chillybeans-23/oae_hardware/oae/oae.png

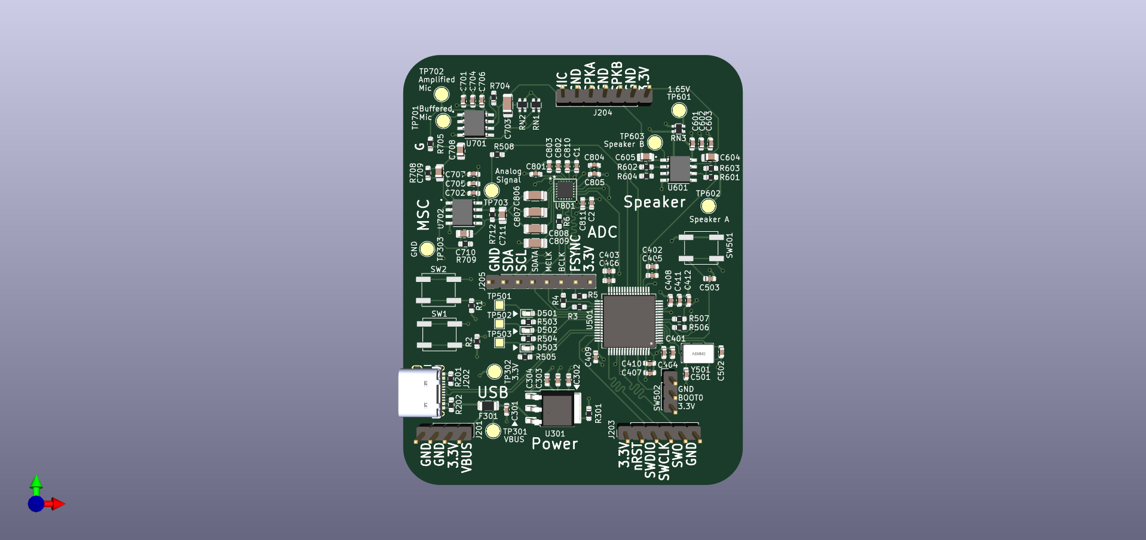
oae/oae.png
