chillybeans-23/oae_hardware/README.md

# OAE Hardware

PCB designs for the OAE prototype.
