chillybeans-23/oae_hardware/physical_ui_prototypes/documentation.md

Purpose: so future students know how reproduce the LED and LCD devices we made. They also have an idea of how to build on our work (keyfob, learnings from codesigns and assembly)

We developed an LCD and an LED UI prototype of the DPOAE device.
