chillybeans-23/oae_hardware/oae/bom.xlsx

Id | Designator | Footprint | Quantity | Comment | Supplier and ref
1 | TP302 | TestPoint_Pad_D2.5mm | 1 | 3V3
2 | C304,C704,C404,C408,C801,C409,C503,C810,C705,C602 | C_0603_1608Metric | 10 | 1uF
3 | C702,C601,C405,C406,C410,C701,C412 | C_0603_1608Metric | 7 | 100nF
4 | J206 | PinHeader_1x05_P2.54mm_Vertical | 1 | BMS Connector
5 | C804,C301,C706,C811,C603,C303,C802,C707,C401 | C_0603_1608Metric | 9 | 10uF
6 | TP701 | TestPoint_Pad_D2.5mm | 1 | MIC_BUFF
7 | R504,R503,R505 | R_0603_1608Metric_Pad0.98x0.95mm_HandSolder | 3 | 200
8 | R201,R202 | R_0603_1608Metric_Pad0.98x0.95mm_HandSolder | 2 | 5.1K
9 | J207 | PinHeader_1x06_P2.54mm_Vertical | 1 | GPIO Header
10 | R604,R603 | R_0603_1608Metric_Pad0.98x0.95mm_HandSolder | 2 | 499
11 | C605,C604 | C_0805_2012Metric_Pad1.18x1.45mm_HandSolder | 2 | >2uF
12 | R708,R709,R705,R712 | R_0603_1608Metric_Pad0.98x0.95mm_HandSolder | 4 | 2K
13 | TP502 | TestPoint_Pad_1.5x1.5mm | 1 | DBG2
14 | C708,C710 | C_0805_2012Metric_Pad1.18x1.45mm_HandSolder | 2 | 100nF
15 | RN3,RN1,RN2 | R_Array_Convex_2x0603 | 3 | 10K
16 | C2,C803,C805,C1 | C_0603_1608Metric | 4 | 0.1uF
17 | TP603 | TestPoint_Pad_D2.5mm | 1 | SPEAKER_B
18 | C502,C501 | C_0603_1608Metric | 2 | 16pF
19 | R301,R12 | R_0603_1608Metric_Pad0.98x0.95mm_HandSolder | 2 | 0
20 | TP303 | TestPoint_Pad_D2.5mm | 1 | GND
21 | R17,R10,R15,R16,R11,R18 | R_0603_1608Metric_Pad0.98x0.95mm_HandSolder | 6 | 4.7K
22 | J202 | GCT_USB4105-GF-A | 1 | USB_C_Micro
23 | J201 | PinHeader_1x04_P2.54mm_Vertical | 1 | Power Terminal
24 | SW2,SW1 | SW_SPST_EVPBF | 2 | BTN1
25 | TP501 | TestPoint_Pad_1.5x1.5mm | 1 | DBG1
26 | R704,R14,R13 | R_0603_1608Metric_Pad0.98x0.95mm_HandSolder | 3 | 100K
27 | F301 | Fuse_1206_3216Metric | 1 | 1A
28 | J204 | PinHeader_1x07_P2.54mm_Vertical | 1 | Earpiece Connector
29 | D503 | LED_0603_1608Metric | 1 | DBG3
30 | TP301 | TestPoint_Pad_D2.5mm | 1 | VBUS
31 | C809,C703,C806,C808,C807 | C_1206_3216Metric_Pad1.33x1.80mm_HandSolder | 5 | 1uF
32 | R9,R7,R8,R6 | R_0603_1608Metric_Pad0.98x0.95mm_HandSolder | 4 | 33
33 | SW501 | SW_SPST_EVPBF | 1 | RST_BTN
34 | U701 | SOIC127P599X175-8N | 1 | Opamp_Buffer
35 | J203 | PinHeader_1x06_P2.54mm_Vertical | 1 | Programming Header
36 | R602,R601 | R_0603_1608Metric_Pad0.98x0.95mm_HandSolder | 2 | 10K
37 | TP601 | TestPoint_Pad_D2.5mm | 1 | 1V65
38 | C302 | C_0603_1608Metric | 1 | 22uF
39 | TP703 | TestPoint_Pad_D2.5mm | 1 | MIC_FILTERED
40 | C711,C709 | C_0805_2012Metric_Pad1.18x1.45mm_HandSolder | 2 | 10nF
41 | TP503 | TestPoint_Pad_1.5x1.5mm | 1 | DBG3
42 | C411 | C_0603_1608Metric | 1 | 10nF
43 | Y501 | XTAL_ABMM2-8.000MHZ-E2-T | 1 | 8MHz
44 | U702 | SOIC127P599X175-8N | 1 | Bandpass
45 | U3 | LQFP-64_10x10mm_P0.5mm | 1 | STM32L496RGTx
46 | C402,C407,C403 | C_0603_1608Metric | 3 | 4.7uF
47 | SW502 | PinHeader_1x03_P2.54mm_Vertical | 1 | SW_SPDT
48 | U601 | SOIC127P599X175-8N | 1 | Opamp_Speaker
49 | TP602 | TestPoint_Pad_D2.5mm | 1 | SPEAKER_A
50 | U301 | TO-252-3_TabPin2 | 1 | AZ1117-3.3
51 | D502 | LED_0603_1608Metric | 1 | DBG2
52 | U801 | WQFN20_RTE_TEX | 1 | TLV320ADC3120IRTER
53 | D501 | LED_0603_1608Metric | 1 | DBG1
54 | J205 | PinHeader_1x08_P2.54mm_Vertical | 1 | Communication Pins
55 | TP702 | TestPoint_Pad_D2.5mm | 1 | MIC_AMP
56 | J1 | HDMI_A_Molex_208658-1001_Horizontal | 1 | HDMI_A_1.4
