chillybeans-23/oae_hardware/oae/oae.kicad_pcb

## KiCad design oae/oae.kicad_pcb (2025-02-10)

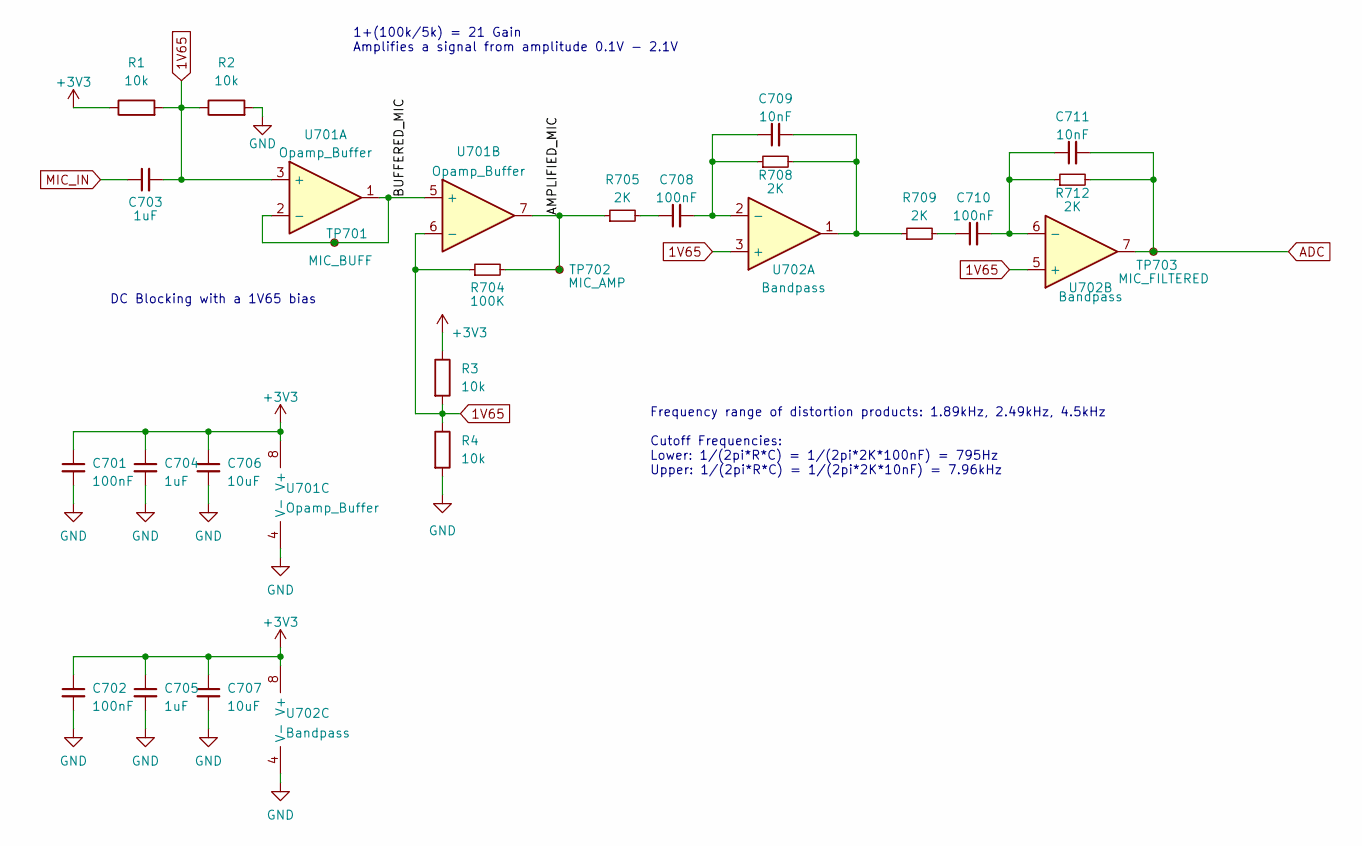
[picture p2: schematic microphone_filter.kicad_sch]

Parts:
C701, C702: 100nF; C_0603_1608Metric
C703: 1uF; C_1206_3216Metric_Pad1.33x1.80mm_HandSolder
C704, C705: 1uF; C_0603_1608Metric
C706, C707: 10uF; C_0603_1608Metric
C708, C710: 100nF; C_1206_3216Metric
C709, C711: 10nF; C_0603_1608Metric
R1, R2, R3, R4: 10k; R_0603_1608Metric
R704: 100K; R_0603_1608Metric_Pad0.98x0.95mm_HandSolder
R705, R708, R709, R712: 2K; R_0603_1608Metric_Pad0.98x0.95mm_HandSolder
TP701: MIC_BUFF; TestPoint_Pad_D2.5mm
TP702: MIC_AMP; TestPoint_Pad_D2.5mm
TP703: MIC_FILTERED; TestPoint_Pad_D2.5mm
U1: PCM1862DBT; C_0603_1608Metric
U701: Opamp_Buffer; SOIC127P599X175-8N; Digikey MCP6022-I/SN-ND
U702: Bandpass; SOIC127P599X175-8N; Digikey MCP6022-I/SN-ND

Connections:
1V65: C703.2, R1.2, R2.1, R3.2, R4.1, R704.1, U701.3 (+), U701.6 (-), U702.3 (+), U702.5 (+); also elsewhere on the board
+3V3: C701.1, C702.1, C704.1, C705.1, C706.1, C707.1, R1.1, R3.1, U701.8 (V+), U702.8 (V+); also elsewhere on the board
/Microphone Filters and Amp/AMPLIFIED_MIC: R704.2, R705.1, TP702.1, U701.7
/Microphone Filters and Amp/BUFFERED_MIC: TP701.1, U701.1, U701.2 (-), U701.5 (+)
ADC: C711.2, R712.2, TP703.1, U702.7; also elsewhere on the board
GND: C701.2, C702.2, C704.2, C705.2, C706.2, C707.2, R2.2, R4.2, U701.4 (V-), U702.4 (V-); also elsewhere on the board
MIC_IN: C703.1; also elsewhere on the board
unnamed: C708.1, R705.2
unnamed: C709.2, R708.2, R709.1, U702.1
unnamed: C710.1, R709.2
unnamed: C708.2, C709.1, R708.1, U702.2 (-)
unnamed: C710.2, C711.1, R712.1, U702.6 (-)

Notes on the sheet:
1+(100k/5k) = 21 Gain Amplifies a signal from amplitude 0.1V - 2.1V
DC Blocking with a 1V65 bias
Frequency range of distortion products: 1.89kHz, 2.49kHz, 4.5kHz Cutoff Frequencies: Lower: 1/(2pi*R*C) = 1/(2pi*2K*100nF) = 795Hz Upper: 1/(2pi*R*C) = 1/(2pi*2K*10nF) = 7.96kHz

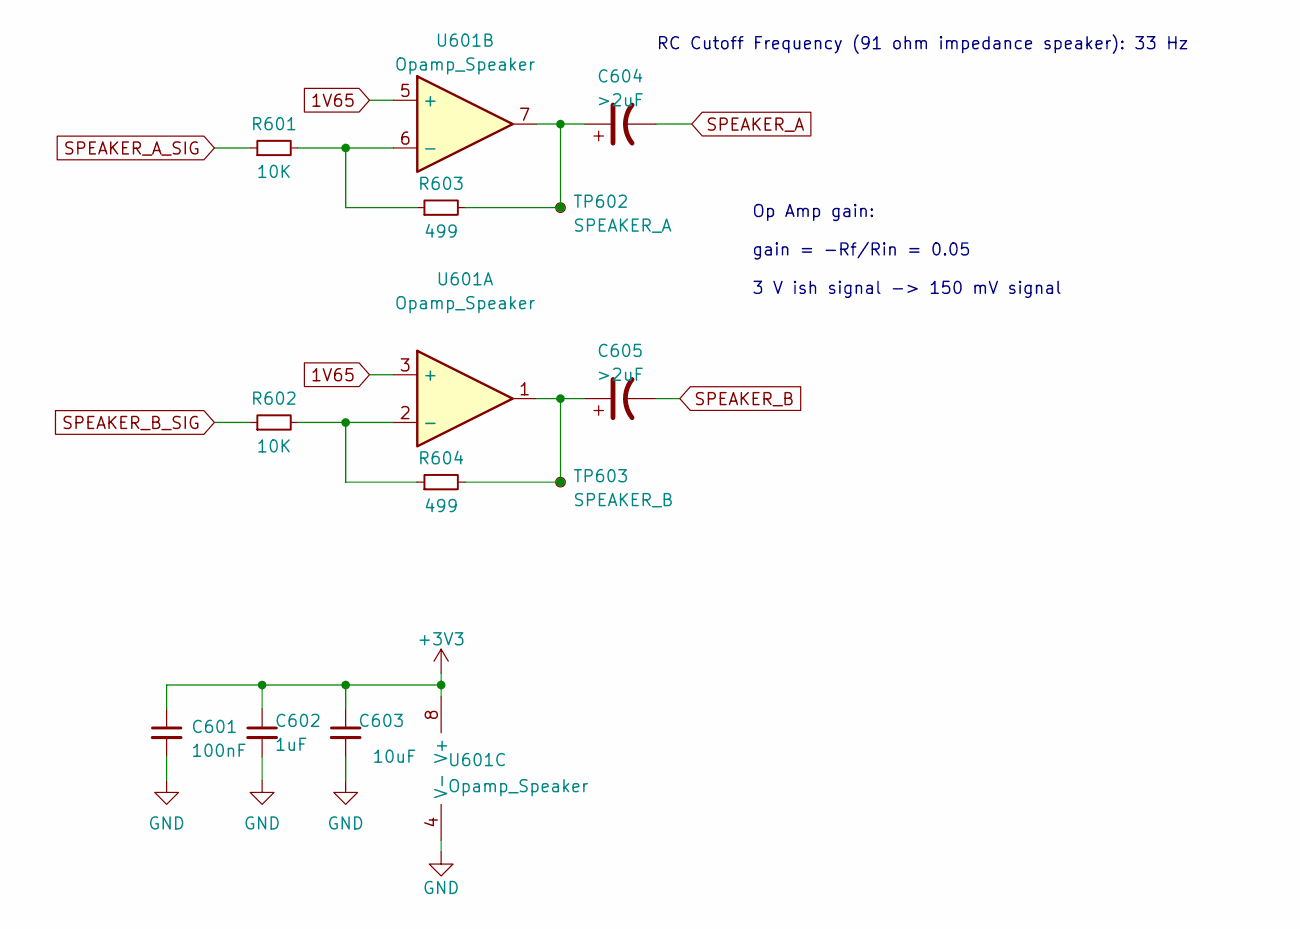
[picture p3: schematic speaker_amp.kicad_sch]

Parts:
C601: 100nF; C_0603_1608Metric
C602: 1uF; C_0603_1608Metric
C603: 10uF; C_0603_1608Metric
C604, C605: >2uF; C_0805_2012Metric_Pad1.18x1.45mm_HandSolder
R601, R602: 10K; R_0603_1608Metric_Pad0.98x0.95mm_HandSolder
R603, R604: 499; R_0603_1608Metric_Pad0.98x0.95mm_HandSolder
TP602: SPEAKER_A; TestPoint_Pad_D2.5mm
TP603: SPEAKER_B; TestPoint_Pad_D2.5mm
U601: Opamp_Speaker; SOIC127P599X175-8N; Digikey MCP6022-I/SN-ND

Connections:
1V65: U601.3 (+), U601.5 (+); also elsewhere on the board
+3V3: C601.1, C602.1, C603.1, U601.8 (V+); also elsewhere on the board
GND: C601.2, C602.2, C603.2, U601.4 (V-); also elsewhere on the board
unnamed: C604.1, R603.2, TP602.1, U601.7
unnamed: C605.1, R604.2, TP603.1, U601.1
unnamed: R602.2, R604.1, U601.2 (-)
unnamed: R601.2, R603.1, U601.6 (-)
SPEAKER_A: C604.2; also elsewhere on the board
SPEAKER_A_SIG: R601.1; also elsewhere on the board
SPEAKER_B: C605.2; also elsewhere on the board
SPEAKER_B_SIG: R602.1; also elsewhere on the board

Notes on the sheet:
Op Amp gain: gain = -Rf/Rin = 0.05 3 V ish signal -> 150 mV signal
RC Cutoff Frequency (91 ohm impedance speaker): 33 Hz

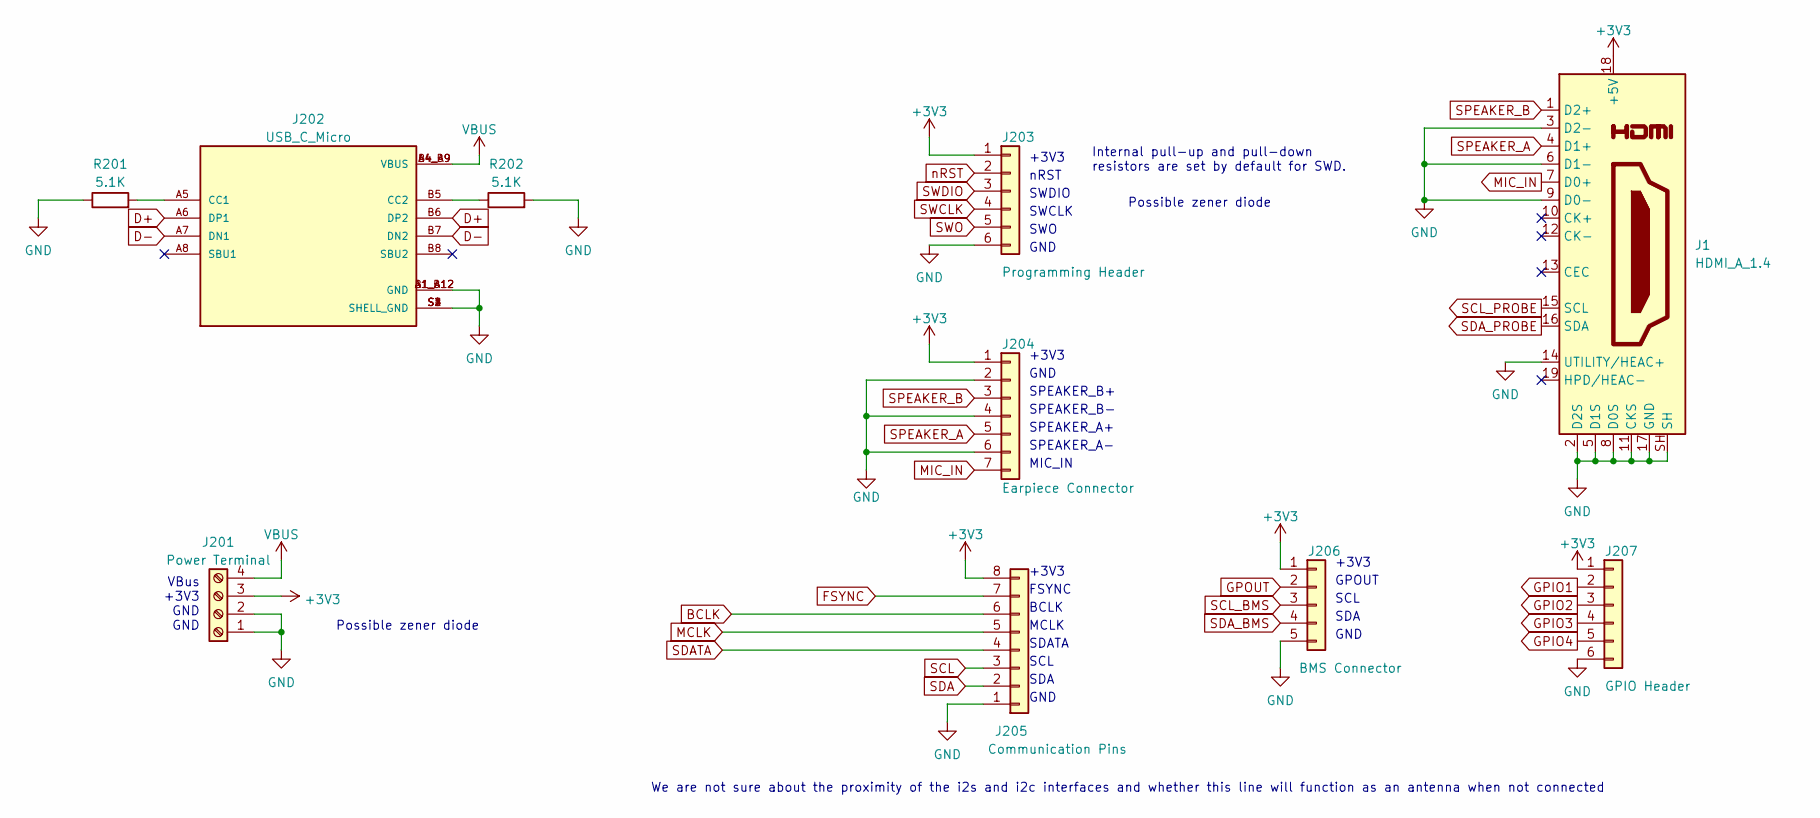
[picture p4: schematic interface.kicad_sch]

Parts:
J1: HDMI_A_1.4; HDMI_A_Molex_208658-1001_Horizontal
J201: Power Terminal; PinHeader_1x04_P2.54mm_Vertical
J202: USB_C_Micro; GCT_USB4105-GF-A; PARTREV A3
J203: Programming Header; PinHeader_1x06_P2.54mm_Vertical
J204: Earpiece Connector; PinHeader_1x07_P2.54mm_Vertical
J205: Communication Pins; PinHeader_1x08_P2.54mm_Vertical
J206: BMS Connector; PinHeader_1x05_P2.54mm_Vertical
J207: GPIO Header; PinHeader_1x06_P2.54mm_Vertical
R201, R202: 5.1K; R_0603_1608Metric_Pad0.98x0.95mm_HandSolder

Connections:
+3V3: J1.18 (+5V), J201.3, J203.1, J204.1, J205.8, J206.1, J207.1; also elsewhere on the board
BCLK: J205.6; also elsewhere on the board
D+: J202.A6 (DP1), J202.B6 (DP2); also elsewhere on the board
D-: J202.A7 (DN1), J202.B7 (DN2); also elsewhere on the board
FSYNC: J205.7; also elsewhere on the board
GND: J1.2 (D2S), J1.3 (D2-), J1.5 (D1S), J1.6 (D1-), J1.8 (D0S), J1.9 (D0-), J1.11 (CKS), J1.14 (UTILITY/HEAC+), J1.17 (GND), J1.SH, J201.1, J201.2, J202.A1_B12 (GND), J202.B1_A12 (GND), J202.S1 (SHELL_GND), J202.S2 (SHELL_GND), J202.S3 (SHELL_GND), J202.S4 (SHELL_GND), J203.6, J204.2, J204.4, J204.6, J205.1, J206.5, J207.6, R201.1, R202.2; also elsewhere on the board
GPIO1: J207.2; also elsewhere on the board
GPIO2: J207.3; also elsewhere on the board
GPIO3: J207.4; also elsewhere on the board
GPIO4: J207.5; also elsewhere on the board
GPOUT: J206.2; also elsewhere on the board
MCLK: J205.5; also elsewhere on the board
MIC_IN: J1.7 (D0+), J204.7; also elsewhere on the board
unnamed: J202.A5 (CC1), R201.2
unnamed: J202.B5 (CC2), R202.1
SCL: J205.3; also elsewhere on the board
SCL_BMS: J206.3; also elsewhere on the board
SCL_PROBE: J1.15 (SCL); also elsewhere on the board
SDA: J205.2; also elsewhere on the board
SDATA: J205.4; also elsewhere on the board
SDA_BMS: J206.4; also elsewhere on the board
SDA_PROBE: J1.16 (SDA); also elsewhere on the board
SPEAKER_A: J1.4 (D1+), J204.5; also elsewhere on the board
SPEAKER_B: J1.1 (D2+), J204.3; also elsewhere on the board
SWCLK: J203.4; also elsewhere on the board
SWDIO: J203.3; also elsewhere on the board
SWO: J203.5; also elsewhere on the board
VBUS: J201.4, J202.A4_B9 (VBUS), J202.B4_A9 (VBUS); also elsewhere on the board
nRST: J203.2; also elsewhere on the board

Notes on the sheet:
SPEAKER_B-
SWO
MIC_IN
GND
VBus +3V3 GND GND
MCLK
nRST
SPEAKER_A+
+3V3
FSYNC
SCL
GPOUT
Internal pull-up and pull-down resistors are set by default for SWD.
Possible zener diode
We are not sure about the proximity of the i2s and i2c interfaces and whether this line will function as an antenna when not connected
SWCLK
SDA
SPEAKER_A-
SWDIO
BCLK
SPEAKER_B+
SDATA
SCL

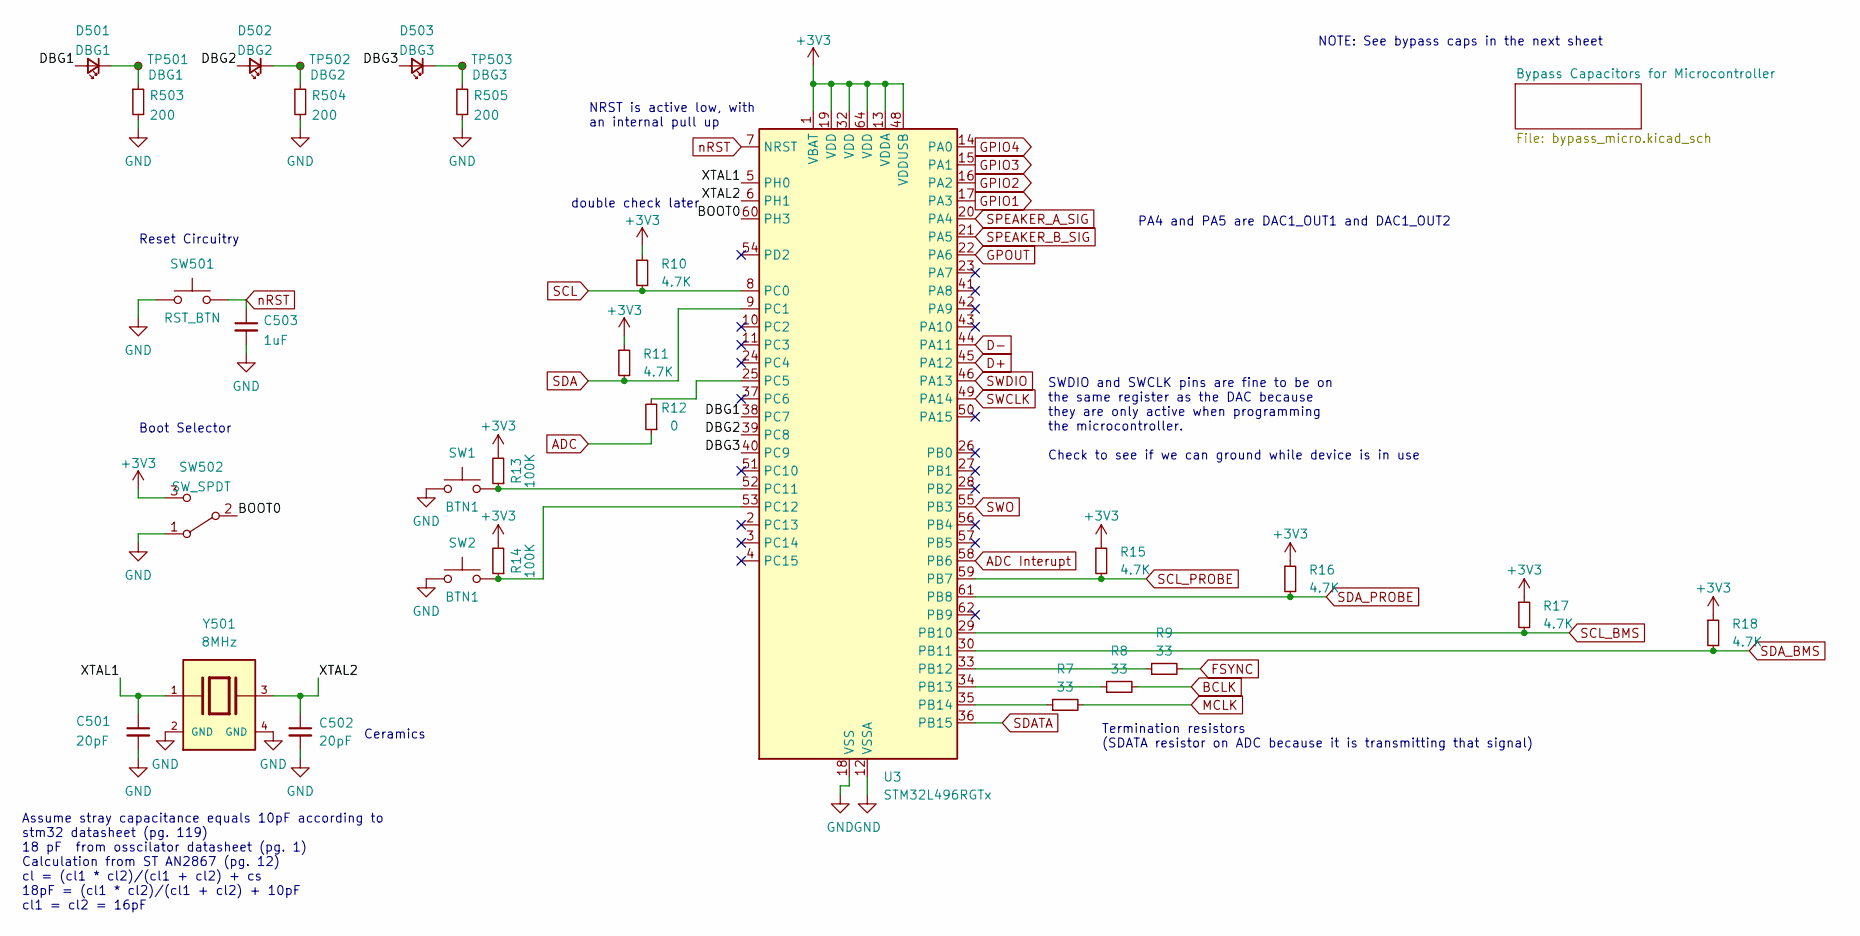
[picture p5: schematic microcontroller.kicad_sch]

Parts:
C501, C502: 20pF; C_0603_1608Metric
C503: 1uF; C_0603_1608Metric
D501: DBG1; LED_0603_1608Metric
D502: DBG2; LED_0603_1608Metric
D503: DBG3; LED_0603_1608Metric
R7, R8, R9: 33; R_0603_1608Metric_Pad0.98x0.95mm_HandSolder
R10, R11, R15, R16, R17, R18: 4.7K; R_0603_1608Metric_Pad0.98x0.95mm_HandSolder
R12: 0; R_0603_1608Metric_Pad0.98x0.95mm_HandSolder
R13, R14: 100K; R_0603_1608Metric_Pad0.98x0.95mm_HandSolder
R503, R504, R505: 200; R_0603_1608Metric_Pad0.98x0.95mm_HandSolder
SW1, SW2: BTN1; SW_SPST_EVPBF; DigiKey P19749DKR-ND
SW501: RST_BTN; SW_SPST_EVPBF; DigiKey P19749DKR-ND
SW502: SW_SPDT; PinHeader_1x03_P2.54mm_Vertical
TP501: DBG1; TestPoint_Pad_1.5x1.5mm
TP502: DBG2; TestPoint_Pad_1.5x1.5mm
TP503: DBG3; TestPoint_Pad_1.5x1.5mm
U3: STM32L496RGTx; LQFP-64_10x10mm_P0.5mm
Y501: 8MHz; XTAL_ABMM2-8.000MHZ-E2-T; PARTREV 01.18.13

Connections:
+3V3: R10.1, R11.1, R13.2, R14.2, R15.1, R16.1, R17.1, R18.1, SW502.3 (C), U3.1 (VBAT), U3.13 (VDDA), U3.19 (VDD), U3.32 (VDD), U3.48 (VDDUSB), U3.64 (VDD); also elsewhere on the board
/Microcontroller/BOOT0: SW502.2 (B), U3.60 (PH3)
/Microcontroller/DBG1: D501.2 (A), U3.38 (PC7)
/Microcontroller/DBG2: D502.2 (A), U3.39 (PC8)
/Microcontroller/DBG3: D503.2 (A), U3.40 (PC9)
/Microcontroller/XTAL1: C501.1, U3.5 (PH0), Y501.1
/Microcontroller/XTAL2: C502.1, U3.6 (PH1), Y501.3
ADC: R12.1; also elsewhere on the board
ADC Interupt: U3.58 (PB6); also elsewhere on the board
BCLK: R8.2; also elsewhere on the board
D+: U3.45 (PA12); also elsewhere on the board
D-: U3.44 (PA11); also elsewhere on the board
FSYNC: R9.2; also elsewhere on the board
GND: C501.2, C502.2, C503.2, R503.2, R504.2, R505.2, SW1.1, SW2.1, SW501.1, SW502.1 (A), U3.12 (VSSA), U3.18 (VSS), U3.31 (VSS), U3.47 (VSS), U3.63 (VSS), Y501.2 (GND), Y501.4 (GND); also elsewhere on the board
GPIO1: U3.17 (PA3); also elsewhere on the board
GPIO2: U3.16 (PA2); also elsewhere on the board
GPIO3: U3.15 (PA1); also elsewhere on the board
GPIO4: U3.14 (PA0); also elsewhere on the board
GPOUT: U3.22 (PA6); also elsewhere on the board
MCLK: R7.2; also elsewhere on the board
unnamed: D501.1 (K), R503.1, TP501.1
unnamed: D502.1 (K), R504.1, TP502.1
unnamed: D503.1 (K), R505.1, TP503.1
unnamed: R9.1, U3.33 (PB12)
unnamed: R8.1, U3.34 (PB13)
unnamed: R7.1, U3.35 (PB14)
unnamed: R12.2, U3.25 (PC5)
unnamed: R13.1, SW1.2, U3.52 (PC11)
unnamed: R14.1, SW2.2, U3.53 (PC12)
SCL: R10.2, U3.8 (PC0); also elsewhere on the board
SCL_BMS: R17.2, U3.29 (PB10); also elsewhere on the board
SCL_PROBE: R15.2, U3.59 (PB7); also elsewhere on the board
SDA: R11.2, U3.9 (PC1); also elsewhere on the board
SDATA: U3.36 (PB15); also elsewhere on the board
SDA_BMS: R18.2, U3.30 (PB11); also elsewhere on the board
SDA_PROBE: R16.2, U3.61 (PB8); also elsewhere on the board
SPEAKER_A_SIG: U3.20 (PA4); also elsewhere on the board
SPEAKER_B_SIG: U3.21 (PA5); also elsewhere on the board
SWCLK: U3.49 (PA14); also elsewhere on the board
SWDIO: U3.46 (PA13); also elsewhere on the board
SWO: U3.55 (PB3); also elsewhere on the board
nRST: C503.1, SW501.2, U3.7 (NRST); also elsewhere on the board

Notes on the sheet:
Ceramics
Termination resistors (SDATA resistor on ADC because it is transmitting that signal)
Reset Circuitry
Boot Selector
NRST is active low, with an internal pull up
Assume stray capacitance equals 10pF according to stm32 datasheet (pg. 119) 18 pF from osscilator datasheet (pg. 1) Calculation from ST AN2867 (pg. 12) cl = (cl1 * cl2)/(cl1 + cl2) + cs 18pF = (cl1 * cl2)/(cl1 + cl2) + 10pF cl1 = cl2 = 16pF
double check later
NOTE: See bypass caps in the next sheet
PA4 and PA5 are DAC1_OUT1 and DAC1_OUT2
SWDIO and SWCLK pins are fine to be on the same register as the DAC because they are only active when programming the microcontroller. Check to see if we can ground while device is in use

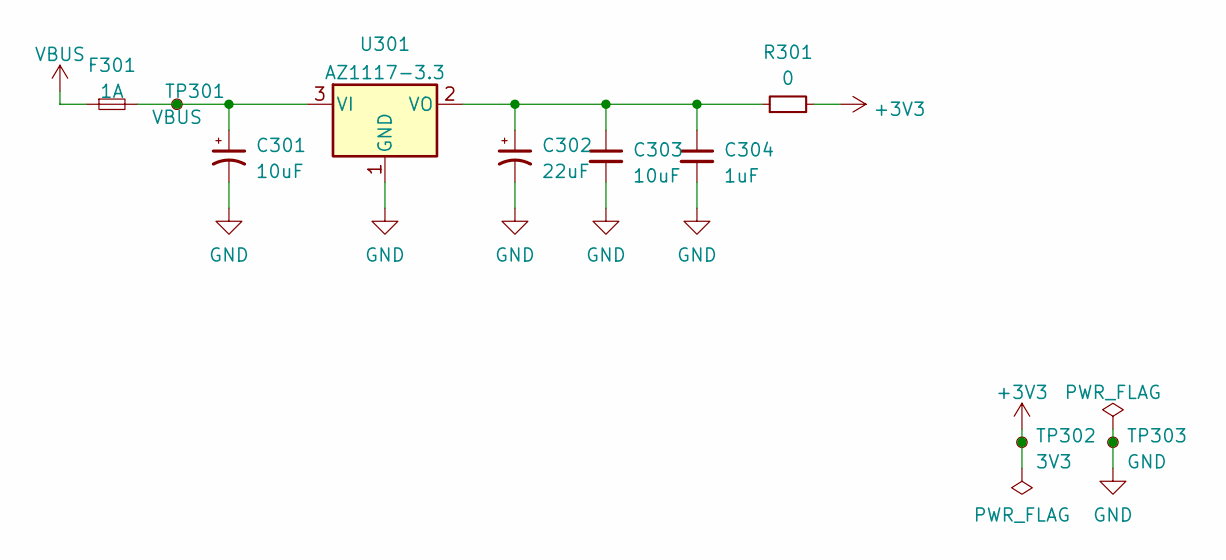
[picture p6: schematic power.kicad_sch]

Parts:
C301, C303: 10uF; C_0603_1608Metric
C302: 22uF; C_0603_1608Metric
C304: 1uF; C_0603_1608Metric
F301: 1A; Fuse_1206_3216Metric; DigiKey 507-1806-6-ND
R301: 0; R_0603_1608Metric_Pad0.98x0.95mm_HandSolder
TP301: VBUS; TestPoint_Pad_D2.5mm
TP302: 3V3; TestPoint_Pad_D2.5mm
TP303: GND; TestPoint_Pad_D2.5mm
U301: AZ1117-3.3; TO-252-3_TabPin2; DigiKey AZ1117CD-3.3TRG1DIDKR-ND

Connections:
+3V3: R301.2, TP302.1; also elsewhere on the board
GND: C301.2, C302.2, C303.2, C304.2, TP303.1, U301.1 (GND); also elsewhere on the board
unnamed: C301.1, F301.2, TP301.1, U301.3 (VI)
unnamed: C302.1, C303.1, C304.1, R301.1, U301.2 (VO)
VBUS: F301.1; also elsewhere on the board

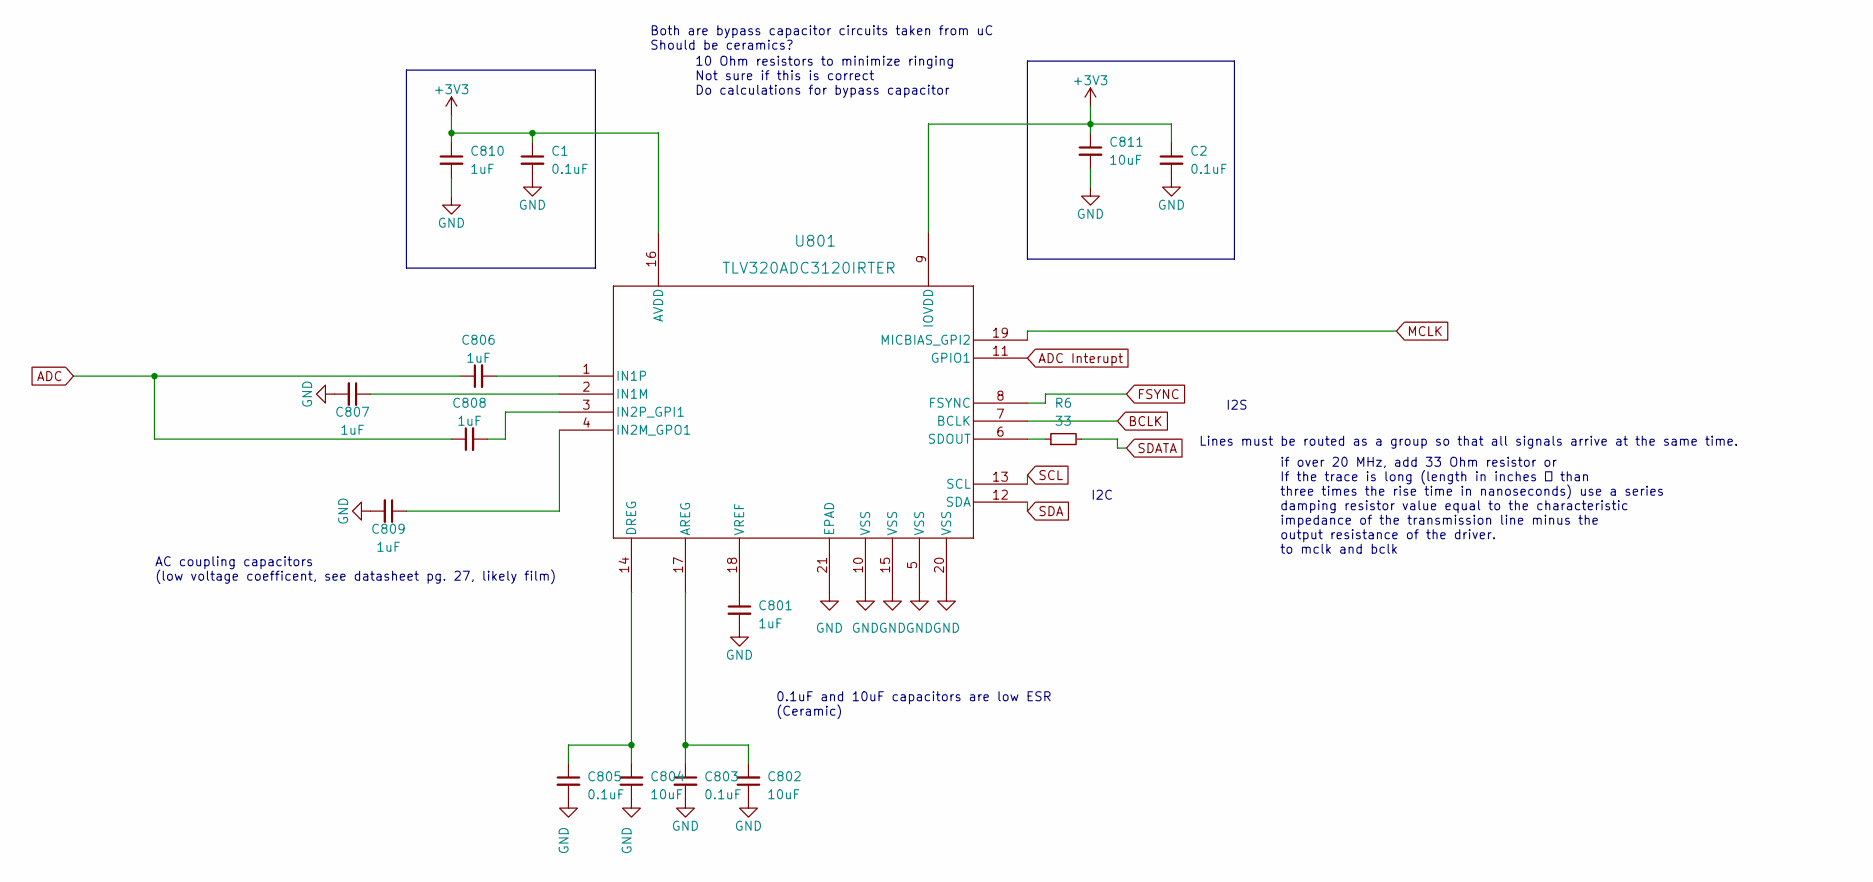
[picture p7: schematic adc.kicad_sch]

Parts:
C1, C2, C803, C805: 0.1uF; C_0603_1608Metric
C801, C810: 1uF; C_0603_1608Metric
C802, C804, C811: 10uF; C_0603_1608Metric
C806, C807, C808, C809: 1uF; C_1206_3216Metric_Pad1.33x1.80mm_HandSolder
R6: 33; R_0603_1608Metric_Pad0.98x0.95mm_HandSolder
U801: TLV320ADC3120IRTER; WQFN20_RTE_TEX

Connections:
+3V3: C1.1, C2.1, C810.1, C811.1, U801.9 (IOVDD), U801.16 (AVDD); also elsewhere on the board
ADC: C806.1, C808.1; also elsewhere on the board
ADC Interupt: U801.11 (GPIO1); also elsewhere on the board
BCLK: U801.7 (BCLK); also elsewhere on the board
FSYNC: U801.8 (FSYNC); also elsewhere on the board
GND: C1.2, C2.2, C801.2, C802.1, C803.2, C804.1, C805.2, C807.2, C809.2, C810.2, C811.2, U801.5 (VSS), U801.10 (VSS), U801.15 (VSS), U801.20 (VSS), U801.21 (EPAD); also elsewhere on the board
MCLK: U801.19 (MICBIAS_GPI2); also elsewhere on the board
unnamed: C802.2, C803.1, U801.17 (AREG)
unnamed: C804.2, C805.1, U801.14 (DREG)
unnamed: C807.1, U801.2 (IN1M)
unnamed: C806.2, U801.1 (IN1P)
unnamed: C809.1, U801.4 (IN2M_GPO1)
unnamed: C808.2, U801.3 (IN2P_GPI1)
unnamed: R6.1, U801.6 (SDOUT)
unnamed: C801.1, U801.18 (VREF)
SCL: U801.13 (SCL); also elsewhere on the board
SDA: U801.12 (SDA); also elsewhere on the board
SDATA: R6.2; also elsewhere on the board

Notes on the sheet:
AC coupling capacitors (low voltage coefficent, see datasheet pg. 27, likely film)
I2C
10 Ohm resistors to minimize ringing Not sure if this is correct Do calculations for bypass capacitor
0.1uF and 10uF capacitors are low ESR (Ceramic)
if over 20 MHz, add 33 Ohm resistor or If the trace is long (length in inches   than three times the rise time in nanoseconds) use a series damping resistor value equal to the characteristic impedance of the transmission line minus the output resistance of the driver. to mclk and bclk
I2S
Lines must be routed as a group so that all signals arrive at the same time.
Both are bypass capacitor circuits taken from uC Should be ceramics?

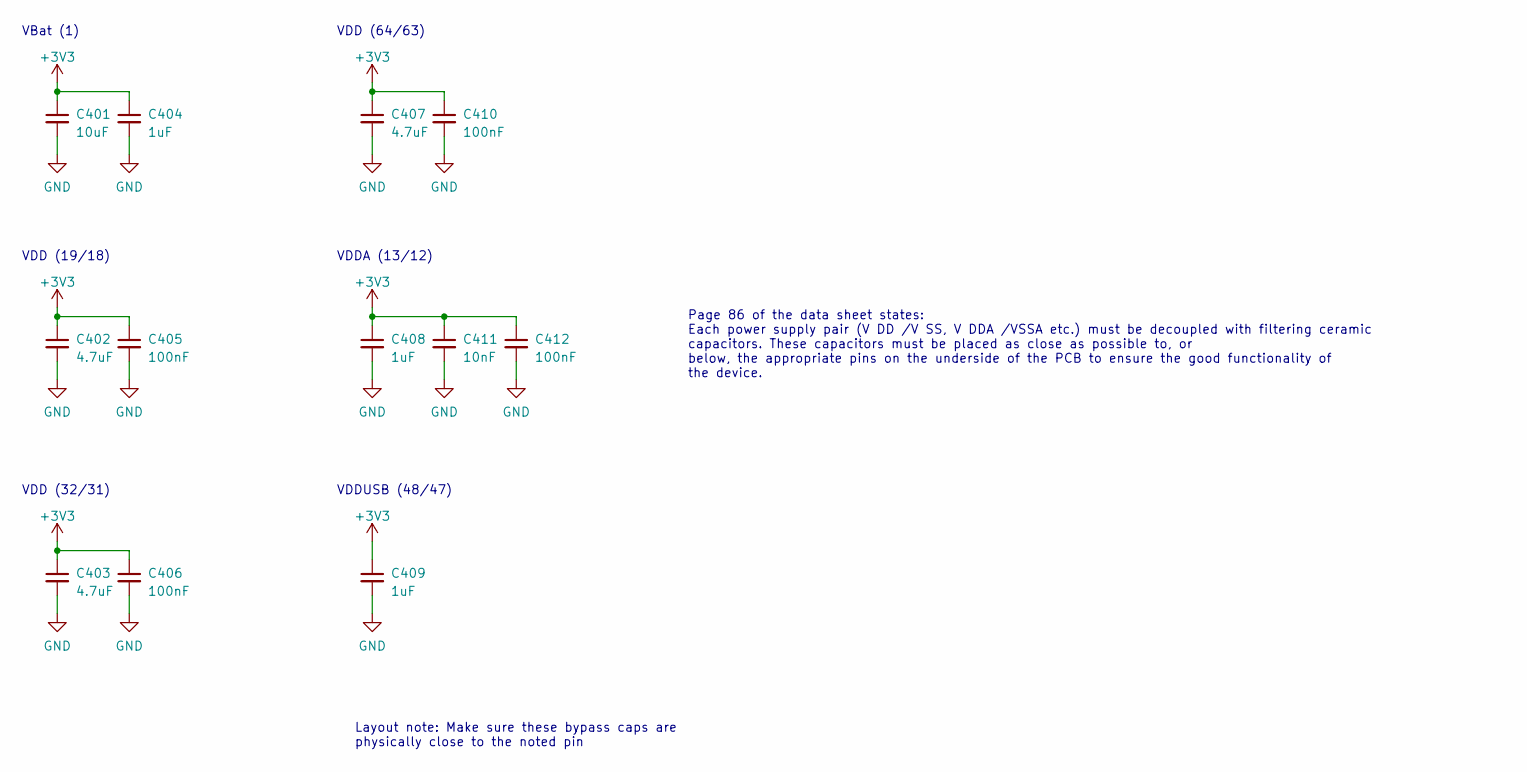
[picture p8: schematic bypass_micro.kicad_sch]

Parts:
C401: 10uF; C_0603_1608Metric
C402, C403, C407: 4.7uF; C_0603_1608Metric
C404, C408, C409: 1uF; C_0603_1608Metric
C405, C406, C410, C412: 100nF; C_0603_1608Metric
C411: 10nF; C_0603_1608Metric

Connections:
+3V3: C401.1, C402.1, C403.1, C404.1, C405.1, C406.1, C407.1, C408.1, C409.1, C410.1, C411.1, C412.1; also elsewhere on the board
GND: C401.2, C402.2, C403.2, C404.2, C405.2, C406.2, C407.2, C408.2, C409.2, C410.2, C411.2, C412.2; also elsewhere on the board

Notes on the sheet:
VBat (1)
VDD (64/63)
Layout note: Make sure these bypass caps are physically close to the noted pin
VDD (32/31)
VDD (19/18)
VDDA (13/12)
Page 86 of the data sheet states: Each power supply pair (V DD /V SS, V DDA /VSSA etc.) must be decoupled with filtering ceramic capacitors. These capacitors must be placed as close as possible to, or below, the appropriate pins on the underside of the PCB to ensure the good functionality of the de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
VDDUSB (48/47)

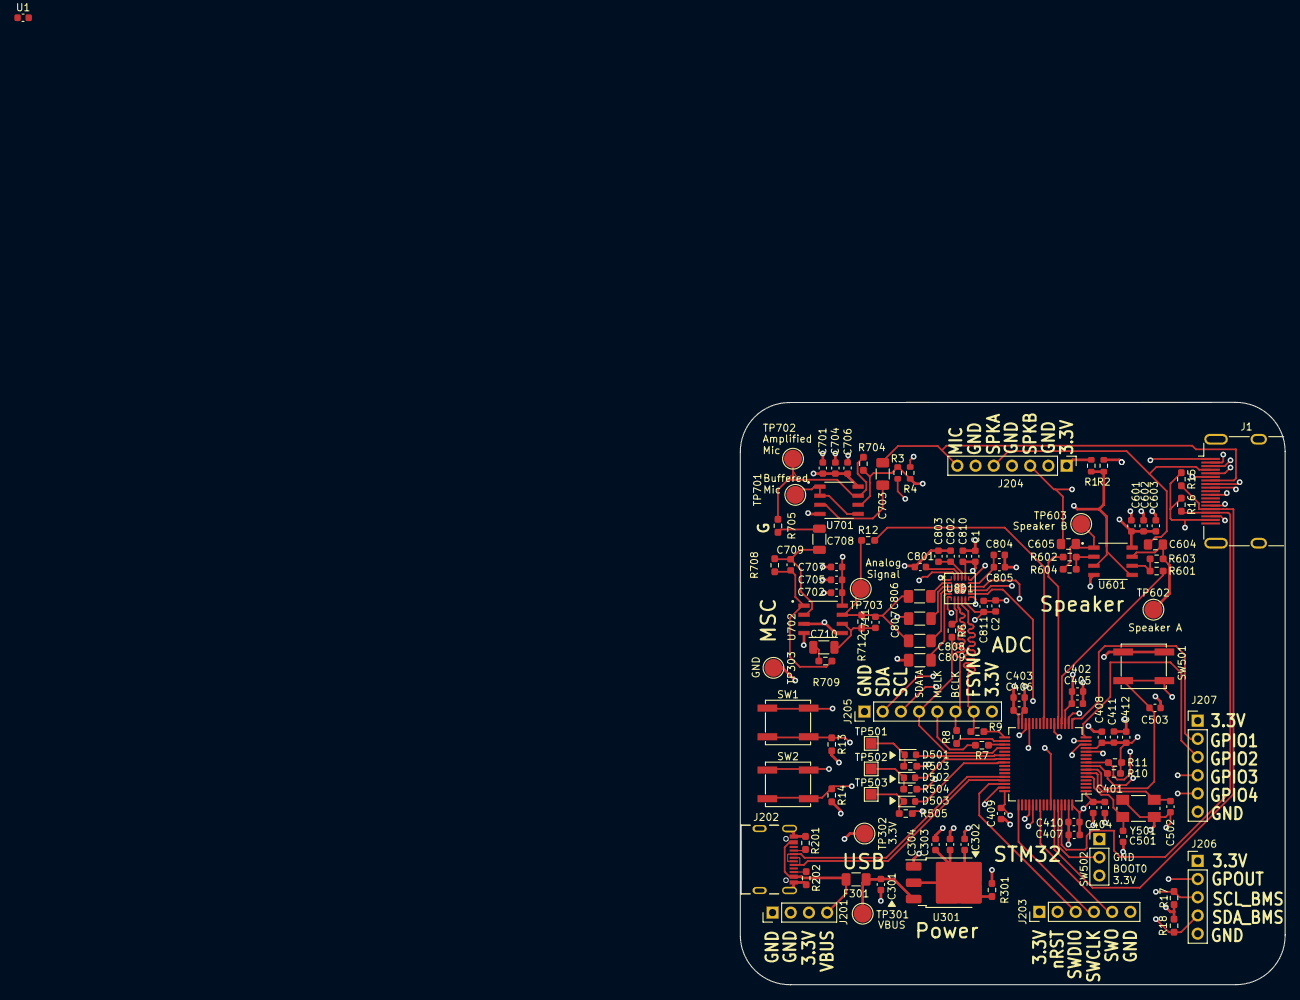
[picture p9: board oae.kicad_pcb from above]

Board: 4 copper layers, 76.0 x 81.2 mm, 115 parts (0 on the bottom side), 70 nets.
