chillybeans-23/oae_hardware/(commit log)

2022-10-19 initialize kicad project
    [oae.kicad_pcb, oae.kicad_sch]
2022-10-27 start schematic design
    [interface.kicad_sch, microcontroller.kicad_sch, microphone_filter.kicad_sch, oae.kicad_sch, power.kicad_sch, speaker_amp.kicad_sch]
2022-11-15 add microcontroller schematics
    [bypass_micro.kicad_sch, interface.kicad_sch, microcontroller.kicad_sch, microphone_filter.kicad_sch, oae.kicad_sch, speaker_amp.kicad_sch]
2022-11-17 fix grid, change to use a separate gnd plane for analog
    [interface.kicad_sch, microphone_filter.kicad_sch, oae.kicad_sch, speaker_amp.kicad_sch]
2022-11-29 first pass layout
    [bypass_micro.kicad_sch, interface.kicad_sch, microcontroller.kicad_sch, microphone_filter.kicad_sch, oae.kicad_pcb, oae.kicad_sch, power.kicad_sch, speaker_amp.kicad_sch]
2022-11-29 udpate ground planes to remove as many big cutouts
    [oae.kicad_pcb]
2022-11-29 add analog and digital labels to the user plane
    [oae.kicad_pcb]
2023-03-27 update pcb to what was shipped
    [adc.kicad_sch, microphone_filter.kicad_sch, oae.kicad_pcb, oae.kicad_sch, speaker_amp.kicad_sch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]
2023-05-05 add external 21 bit adc
    [microphone_filter.kicad_sch, oae.kicad_pcb, oae.kicad_sch]
2023-07-07 Create second revision of OAE schematic
    * Adjusted signal chain amplification issue in schematic
    * Removed schematic short; Added LTSpice schmatic for circuit validation
    * Rearranged buffer/amplifier components on PCB (See comment)
    * Changed LME49723 to MCP6001 RtR
    * Moved voltage divider to non-inverting input
    * Add ADC communication lines
    * Changed resistor footprints
    * Redefined ref voltage; Changed USB socket footprint; Added data lines; Altered Crystal Resonator
    * Add ADC + power wiring into schematic
    * Altered crystal footprint; Switched to USB-C; MCP6022-i/sn in use
    * Fixed VBUS routing
    * Routed USB-C Power
    * Add jumpers for ADC GPIO pins
    * Conde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
    [adc.kicad_sch, adc_communications.kicad_sch, bypass_micro.kicad_sch, interface.kicad_sch, microcontroller.kicad_sch, microphone_filter.kicad_sch, oae.kicad_pcb, oae.kicad_sch]
2023-07-25 PCB Redesign (#2)
    [adc.kicad_sch, bypass_micro.kicad_sch, microcontroller.kicad_sch, microphone_filter.kicad_sch, oae.kicad_pcb, oae.kicad_sch, power.kicad_sch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]
2023-07-28 Fix Values while Matching References (#4)
    * Update board to what was shipped
    * Make value changes for most components
    * Fixed schematic value for overlapping components
    * Commit changes to BOM
    * Update MSC AC coupling capacitor
    * Regenerate teardrops and set speaker capacitors
    * Fix silkscreen issues
    [adc.kicad_sch, bypass_micro.kicad_sch, interface.kicad_sch, microphone_filter.kicad_sch, oae.kicad_pcb, power.kicad_sch, speaker_amp.kicad_sch]
2025-02-09 update to kicad 8
    [adc.kicad_sch, bypass_micro.kicad_sch, interface.kicad_sch, microcontroller.kicad_sch, microphone_filter.kicad_sch, oae.kicad_pcb, oae.kicad_sch, power.kicad_sch]
2025-02-09 revert "update to kicad 8"
    this reverts commit df91ba69a053605010989058b68ccee6b0fb54dd.
    [adc.kicad_sch, bypass_micro.kicad_sch, interface.kicad_sch, microcontroller.kicad_sch, microphone_filter.kicad_sch, oae.kicad_pcb, oae.kicad_sch, power.kicad_sch]
2025-02-10 Add OAE CliffBar (#5)
    * add new mcu in stm32l4 series for more ram
    * Add HDMI connector and BMS header pin connector
    * edit bms port
    * update pcb layout with new mcu
    * update changes to hdmi cable, add new components in layout
    * fix 3d models, finish layout 1st draft
    * fix gnd via, update back silkscreen
    * add bom and footprint positions
    * wip
    * update to kicad 8
    ---------
    [adc.kicad_sch, bom.xlsx, bypass_micro.kicad_sch, interface.kicad_sch, microcontroller.kicad_sch, microphone_filter.kicad_sch, oae.kicad_pcb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]
